techn0man1ac/SimpleMusclesSensor/Imgs/Electrodes/20230824_162354.jpg

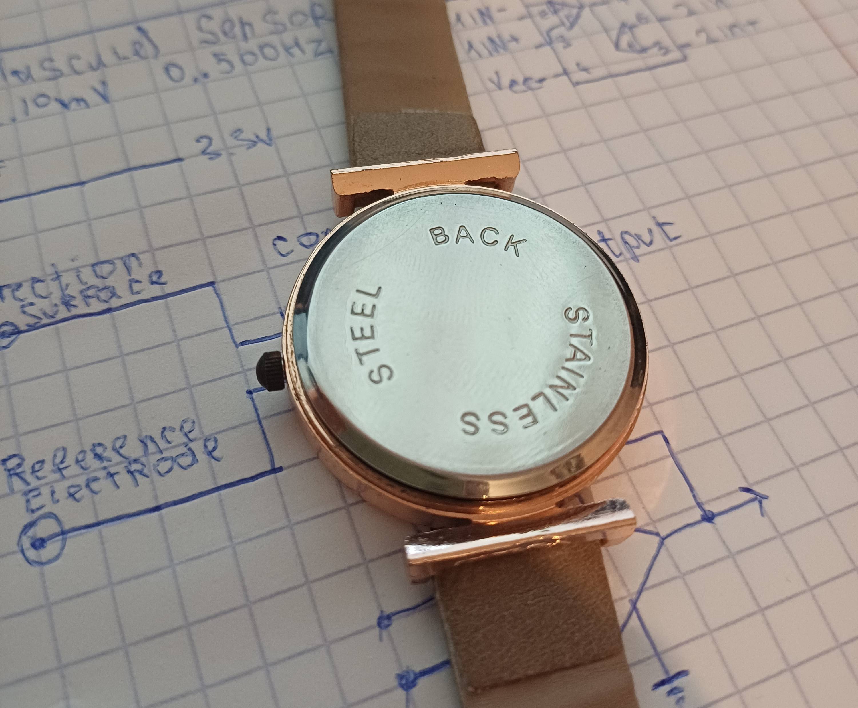
Imgs/Electrodes/20230824_162354.jpg
