techn0man1ac/SimpleMusclesSensor/Imgs/Electrodes/20230825_123516.jpg

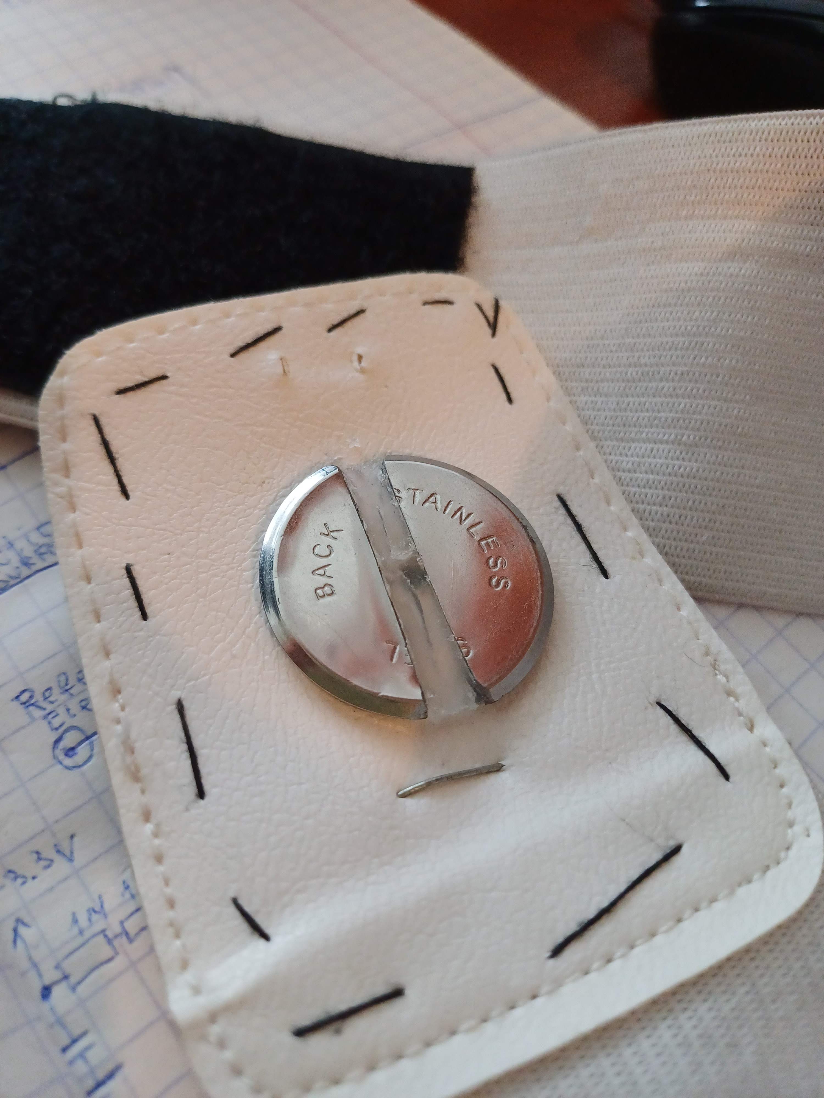
Imgs/Electrodes/20230825_123516.jpg
