techn0man1ac/SimpleMusclesSensor/(commit log)

2023-08-26 Change №000
    First code
2023-08-26 Change №001
    Add software link
2023-08-27 Add sensor schematic
    https://oshwlab.com/raznie.podelki/simolemusclessensor
2023-08-27 Change №001
    Add schematic
2023-08-27 Change №002
    Добавив Українську мову
2023-08-27 Change №004
    Add flags icons from this:
    https://github.com/yammadev/flag-icons
2023-08-27 Change №005
    Add English description
2023-08-28 Change №005
    Add new code
2023-08-28 Change №006
    Change schematic url
2023-08-29 Change №007
    Add lang. selecting using flags from here
    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
2023-08-29 Change №008
    Add electrodes photos
2023-08-29 Change №009
    Add Sensor output scope gif
2023-08-29 Change №010
    Add gif with sensor scope signal
2023-08-29 Change №011
    Add English descriptions
2023-08-29 Change №012
    данних->даних
2023-08-29 Change №011
    Нагадування про дотримання заходів безпеки
2023-08-29 Change №014
    Увага->УВАГА
2023-08-31 Change №014
    Add video link
2023-08-31 Change №015
    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
